slundell/dps_charger/doc/images/0_35v.jpg

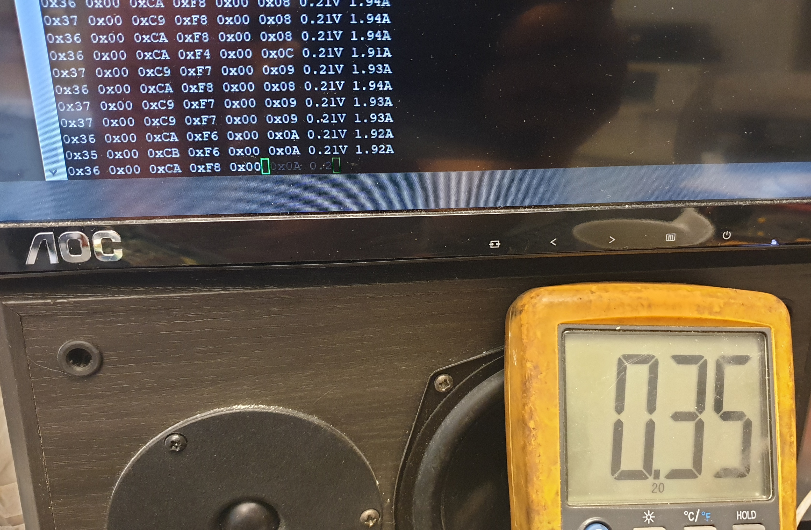
doc/images/0_35v.jpg
