slundell/dps_charger/doc/images/1_94v.jpg

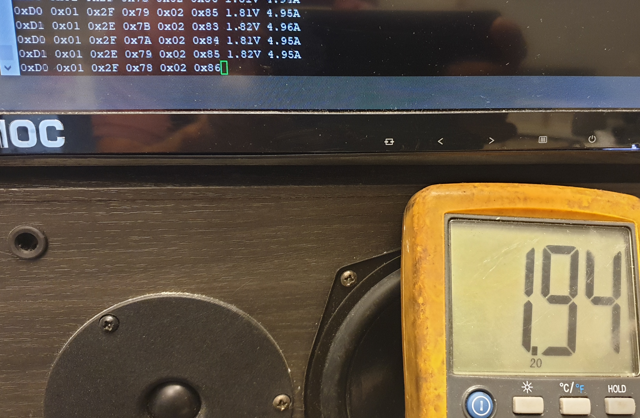
doc/images/1_94v.jpg
