slundell/dps_charger/doc/images/4_45v.jpg

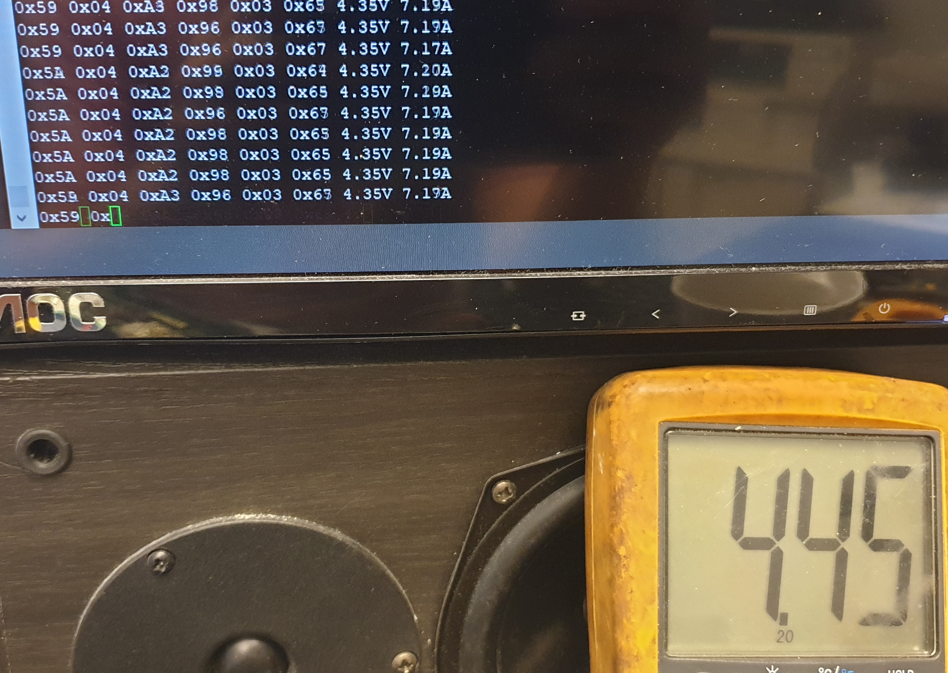
doc/images/4_45v.jpg
