slundell/dps_charger/doc/images/8_73v.jpg

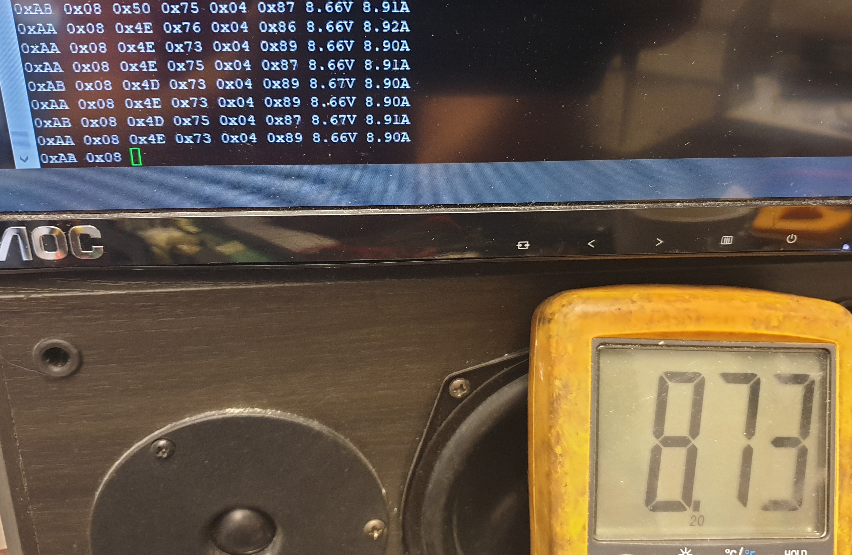
doc/images/8_73v.jpg
