slundell/dps_charger/doc/images/12_42v.jpg

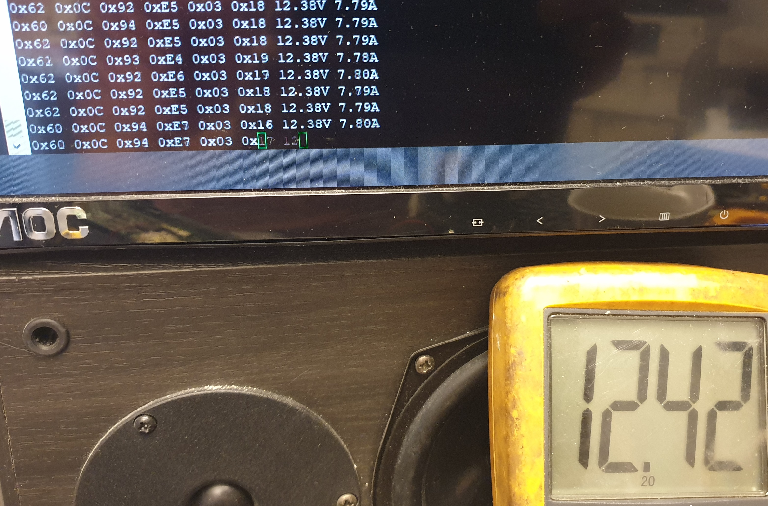
doc/images/12_42v.jpg
