slundell/dps_charger/doc/images/13_68v.jpg

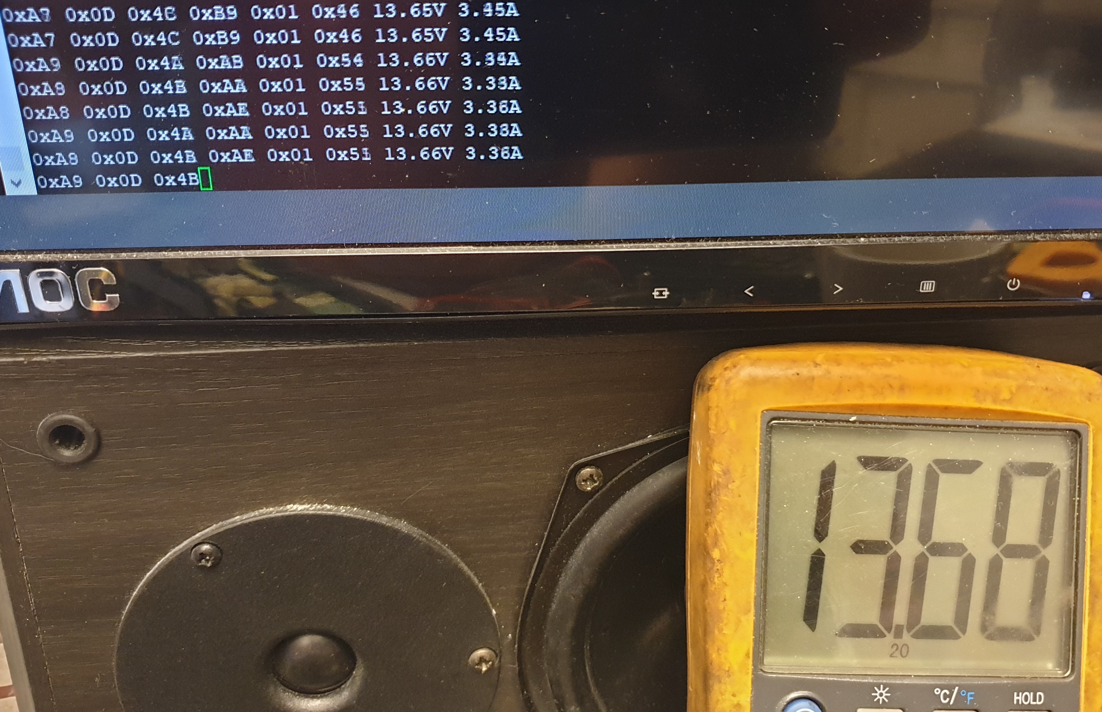
doc/images/13_68v.jpg
