slundell/dps_charger/doc/images/PSU-top.jpg

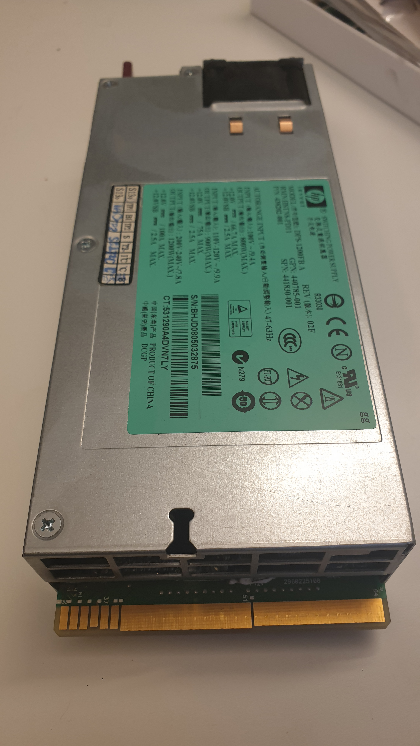
doc/images/PSU-top.jpg
