slundell/dps_charger/doc/random finds/DPS-1200FB turn on resistors.jpg

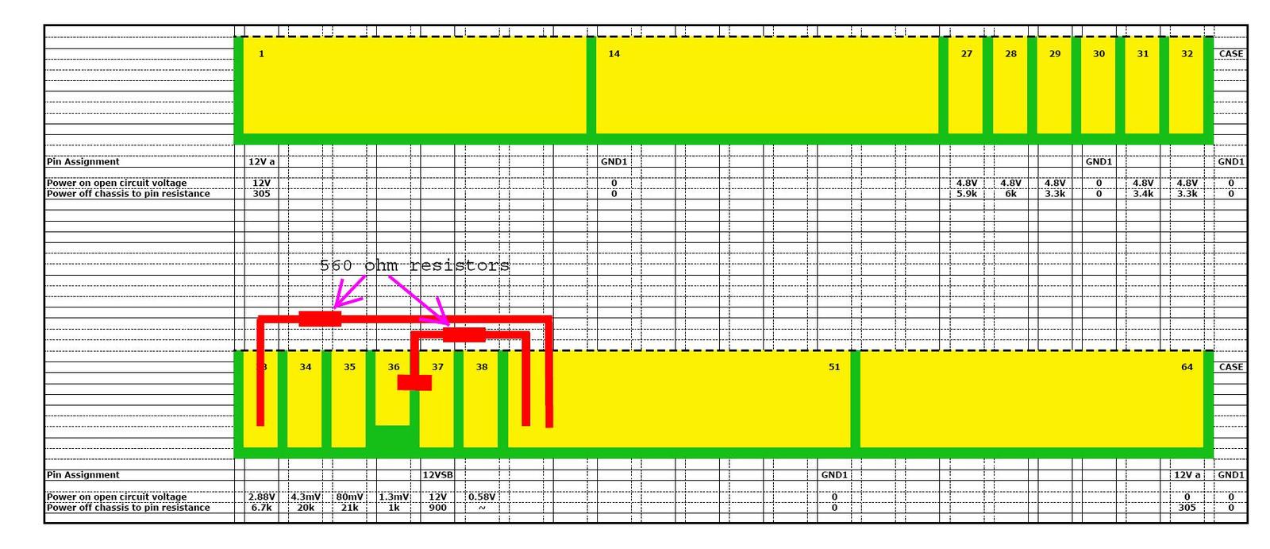
doc/random finds/DPS-1200FB turn on resistors.jpg
