slundell/dps_charger/doc/random finds/pinout.png

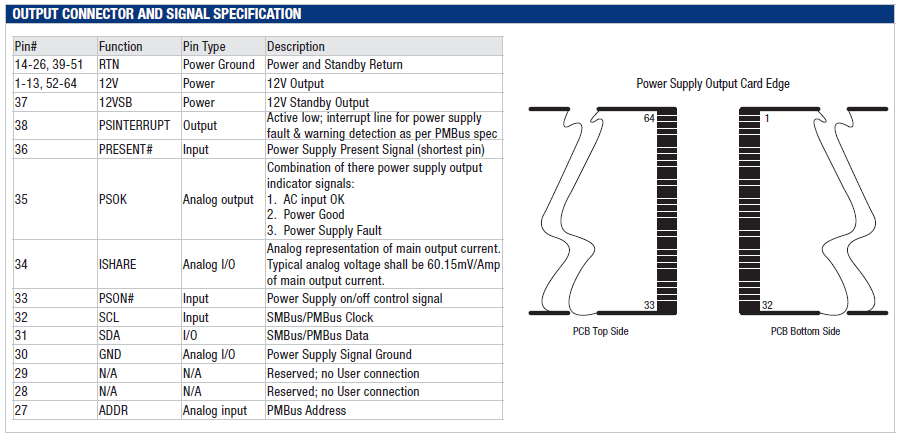
doc/random finds/pinout.png
