slundell/dps_charger/doc/random finds/signals.png

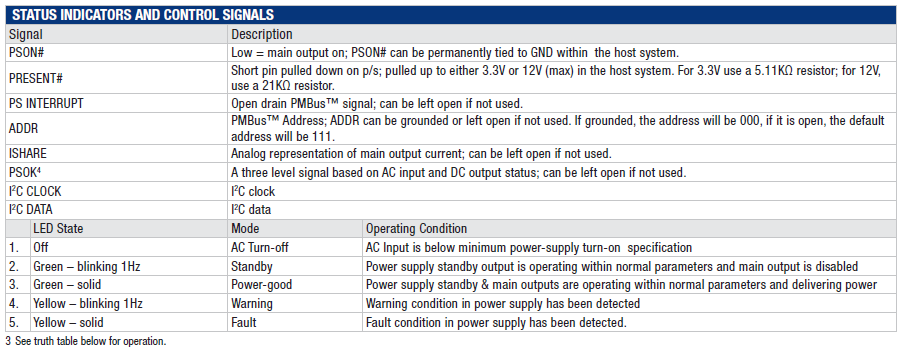
doc/random finds/signals.png
