slundell/dps_charger/(threads)

Thread 1 (2019-09-05):

12VFB Tap

Mateyhv, 2019-09-05:
Hello, I have been following your description and I am interested in lowering the voltage of the PSU to 10,3V so I can set 3xPSUs in series giving 31V. I am not sure how exactly did you set up.. One pin soldered to 12VFB (the whiper), another to 12VSB and the last one to GND but did you disable in some way the voltage control potentiometer on the control board or just leave it there.

Alternatively if I want to use 2xPSU for 30V output I have to increase OVP so the voltage per PSU rises to 15V. If I understood it correctly I have to set a low voltage (~2.70V) to the PIC microcontroller pin #5. How did you do that or better where did you take the voltage from? Did you used another potentiometer? Are there any real issues going up to 15V per PSU?

Thanks

Thread 2 (2020-03-07):

PS Alarm is low everytime?

NilsRo, 2020-03-07:
Hi,

very good project, will adapt the I2C implementation for my charger soon. Actually I am facing that PS Alarm (Pin 38) as low on every PSU and according specification shows a alarm? Is is usual for DPS1200FB?

Regards,
Nils

Thread 3 (2020-10-11):

README pinout error on SCL vs SDA

sparsecli, 2020-10-11:
SDA is 31.
SCL is 32.

The README pin out has reversed the SDA and SCL.

That is confirm by the pinout.png file:
https://github.com/slundell/dps_charger/blob/master/doc/random%20finds/pinout.png

Thread 4 (2020-12-07):

Can you please describe how you were able bypass UVP to reach low voltages like 3.6V

vochong, 2020-12-07:
Hi Simon,

In one of your comments on some other sites, you mentioned that:

"I am hacking/documenting this PSU at https://github.com/slundell/dps_charger . I aim to rebuild it to a fully fledged lab-PSU or charger using an arduino/esp. I have (somehow) managed to work around the UVP. I have some spare cells from an EV project so I tested charging a 16s 20Ah GBS LiFePO4 pack. It happily puts 125A 3.6V through the pack!"

Can you explain how you could bypass OVP to reach low voltages?  I'm very interested in getting the low voltages from this power supply.  Thank you very much.

Thread 5 (2021-01-06):

Voltage adjustment on 12VFB

wegrei, 2021-01-06:
Hi there, thanks for your good explanation. I am planning to build an adjustable battery charger. Try to conttroll output voltage and respectively current by using your method. However I have a problem. Have connected a 12k resistor with a 5k potentiometer in series, the other side of the 20k resistor goes to 12VSB (pin37), the other side of the potentiometer goes to GND (pin 1-14; 39-51) on the board. The wiper goes to 12VFB on the main board as described. With this setup I can adjust the 12VFB from 0v - 2,7V. From 2,7V down to approx. 1,7V the output Voltage stays constant, below that value the unit shuts down. Do you have any idea what is wrong? The model I have is a DPS-1200FB A / HSTNS-PD11 / P/N438202-002
Can you help?
Thanks a lot in advance
Werner
