slundell/dps_charger/src/dps_re.cpp

#include <Arduino.h>
#ifdef ESP8266
#include <ESP8266WiFi.h>
#else
#include <WiFi.h>
#endif
#include <ArduinoOTA.h>


//#define SSI2CMno

//#ifndef SSI2CM
#include "Wire.h"
void my_yield();
void read_all_psu_registers();
void write_psu_mcu_u16(uint8_t, uint16_t);
  
//#else
//#include #include <SlowSoftI2CMaster.h>
//#endif


/*

cf  BANK0:PORTB, RB2 ; turn psu off!
bcf BANK0:PORTC, RC5 ; power off


BANK0:PORTA, RA4 ; adjust I2c address based on address inputs (PA4,PA5,PE3)














0x00: 0D6 ; 'Ö'
0x02: 0B0 ; '°'       ; returns some flags
0x03: 0B1 ; '±'
0x04: 0B2 ; '²'       ; more readable flags
0x05: 0B3 ; '³'
0x06: 0B4 ; '´'       ; status flags incl temperature flags
0x07: 0B5 ; 'µ'
0x08: 0B6 ; '¶'       ; input voltage
0x09: 0B7 ; '·'
0x0A: 0B8 ; '¸'       ; amps in
0x0B: 0B9 ; '¹'
0x0C: 0D7 ; '×'       ; watts in
0x0D: 0D8 ; 'Ø'
0x0E: 0BA ; 'º'       ; output voltage
0x0F: 0BB ; '»'
0x10: 0BC ; '¼'       ; possibly output current
0x11: 0BD ; '½'
0x12: 0D9 ; 'Ù'       ; output watts
0x13: 0DA ; 'Ú'
0x14: 79 ; 'y'
0x15: 79 ; 'y'
0x16: 79 ; 'y'
0x17: 79 ; 'y'
0x18: 79 ; 'y'
0x19: 79 ; 'y'
0x1A: 0BE ; '¾'       ; think this is input air temperature
0x1B: 0BF ; '¿'
0x1C: 0C0 ; 'À'       ; this is some (higher) internal temperature
0x1D: 0C1 ; 'Á'
0x1E: 0C2 ; 'Â'       ; fan speed (rpm?)
0x1F: 0C3 ; 'Ã'
0x20: 79 ; 'y'        ; 
0x21: 79 ; 'y'
0x22: 79 ; 'y'
0x23: 79 ; 'y'
0x24: 79 ; 'y'
0x25: 79 ; 'y'
0x26: 79 ; 'y'
0x27: 79 ; 'y'
0x28: 79 ; 'y'
0x29: 79 ; 'y'
0x2A: 79 ; 'y'
0x2B: 79 ; 'y'
0x2C: 0DB ; 'Û'       ; total watts in (4 bytes)
0x2D: 0DC ; 'Ü'
0x2E: 0DD ; 'Ý'
0x2F: 0DE ; 'Þ'
0x30: 0DF ; 'ß'       ; some simple up-counter (perhaps secs)
0x31: 0E0 ; 'à'
0x32: 0E1 ; 'á'       ; MaxWattsIn
0x33: 0E2 ; 'â'
0x34: 0C4 ; 'Ä'       ; Min recorded input current(?)
0x35: 0C5 ; 'Å'
0x36: 0C6 ; 'Æ'       ; Max recorded output current
0x37: 0C7 ; 'Ç'
0x38: 79 ; 'y'
0x39: 79 ; 'y'
0x3A: 0C8 ; 'È'       ; bitflags ; bits 3,4,5,6 do something
0x3B: 0C9 ; 'É'
0x3C: 0CD ; 'Í'       ; written by cmd 3d
0x3D: 0E4 ; 'ä'
0x3E: 79 ; 'y'
0x3F: 79 ; 'y'
0x40: 0E5 ; 'å'       ; fan related lsb
0x41: 0D4 ; 'Ô'       ; fan related msb
0x42: 79 ; 'y'
0x43: 79 ; 'y'
0x44: 0E6 ; 'æ'
0x45: 0E7 ; 'ç'
0x46: 0E8 ; 'è'
0x47: 0E9 ; 'é'
0x48: 0EA ; 'ê'       ; some value
0x49: 0EB ; 'ë'
0x4A: 0EC ; 'ì'       ; related to above - peak value?
0x4B: 0ED ; 'í'
0x4C: 79 ; 'y'
0x4D: 79 ; 'y'
0x4E: 79 ; 'y'
0x4F: 79 ; 'y'
0x50: 0EE ; 'î'       ; 
0x51: 0EF ; 'ï'
0x52: 0A5 ; '¥'
0x53: 0A6 ; '¦'
0x54: 0A7 ; '§'
0x55: 0A8 ; '¨'
0x56: 0A9 ; '©'
0x57: 0AA ; 'ª'
0x58: 79 ; 'y'
0x59: 79 ; 'y'






*/



   // ! = Known   ? = Guessed
   // T = Tested, A = From asm, D = From doc

bool ignore_registers[0xFF+1];
uint8_t inspect_register;

uint8_t test_cmd  = 0x03;
uint16_t test_data = 0x0000;

void setup_ignore_registers(){


/*

Back-powering the PSU: 

0x02: 0x03 0x06 00000011 00000110 774                   was: 0x03 0x07 00000011 00000111 775
0x04: 0x00 0x09 00000000 00001001 9                     was: 0x00 0x00 00000000 00000000 0
0x06: 0x00 0x20 00000000 00100000 32                    was: 0x00 0x00 00000000 00000000 0

*/



/*  
cmd 0x57=(?0x28) read EEPROM 
max cmd = 0x59 (=?0x29)



*/

/*

ENABLE# LOW

|HP PROLIANT SERVER PS                                 |
| Input: 230.53V  0.13A    | Output: 11.96V  7.59A     |
| Fan: 3360.00/s | Intake: 0.00C  | Internal  86.00C  |
________________________________________________________


0x02: 0x03 0x07 00000011 00000111 775                   was: 0x03 0x02 00000011 00000010 770


*/















  ignore_registers[0x00] = false; 
  ignore_registers[0x02] = false; // [?D] Flags. Power Good?
  ignore_registers[0x04] = false; // [?T] Flags? 0x00 0x00 -> 0x00 0x16 when pulling power
  ignore_registers[0x06] = false; // [?T] Under voltage alarm flag? b.3 = pot3 overflow?
  ignore_registers[0x08] = true;  // [!T] grid voltage
  ignore_registers[0x0A] = true;  // [!T] grid amperage
  ignore_registers[0x0C] = true;  // [!T] grid wattage
  ignore_registers[0x0E] = true;  // [!T] out voltage

  ignore_registers[0x10] = true;  // [!T] out amperage
  ignore_registers[0x12] = true;  // [!T] out wattage
  ignore_registers[0x14] = false;
  ignore_registers[0x16] = false;
  ignore_registers[0x18] = false;
  ignore_registers[0x1A] = true;  // [!T] intake temp
  ignore_registers[0x1C] = true;  // [!T] internal temp
  ignore_registers[0x1E] = true;  // [!T] fan speed actual


  ignore_registers[0x20] = false;
  ignore_registers[0x22] = false;
  ignore_registers[0x24] = false;
  ignore_registers[0x26] = false;
  ignore_registers[0x28] = false;
  ignore_registers[0x2A] = false;  
  ignore_registers[0x2C] = true;  // [!T] Ws in 32bits
  ignore_registers[0x2E] = false;  // [?T] Very slow counter. Resets when unplugging

  
  ignore_registers[0x30] = true;  // [!T] Uptime s
  ignore_registers[0x32] = true;  // [?D] Peak watts in 
  ignore_registers[0x34] = true;  // [?D] Min amps in
  ignore_registers[0x36] = true;  // [?D] Peak amps out
  ignore_registers[0x38] = false; 
  ignore_registers[0x3A] = false; // [?D] Cool flags1 
    // 0x3A:5 seems to be "Power out is on" flag

/*
0x3A: 00000000 00000001
Register 0x3A changed from 0 to 1 after reg 0x3A bit 0
0x3A: 00000000 00000010
Register 0x3A changed from 1 to 2 after reg 0x3A bit 1
0x3A: 00000000 00000100
Register 0x3A changed from 2 to 4 after reg 0x3A bit 2
0x3A: 00000000 00001000
Register 0x3A changed from 4 to 8 after reg 0x3A bit 3
0x3A: 00000000 00010000
Register 0x3A changed from 8 to 16 after reg 0x3A bit 4
0x3A: 00000000 00100000
Register 0x3A changed from 16 to 0 after reg 0x3A bit 5
0x3A: 00000000 01000000
0x3A: 00000000 10000000
0x3A: 00000001 00000000
0x3A: 00000010 00000000
0x3A: 00000100 00000000
0x3A: 00001000 00000000
0x3A: 00010000 00000000
0x3A: 00100000 00000000
0x3A: 01000000 00000000
0x3A: 10000000 00000000

  // 0x3A: 0x00 0x1F 00000000 00011111 31 batt power + grid power                   
  //  was: 0x00 0x3F 00000000 00111111 63 batt power no grid power

  // Last 6b is settable 0x3A: 0x00 0x3F 00000000 00111111 63
*/

  ignore_registers[0x3C] = false; // [?D] Cool flags2
  /* All bits are settable 0x3C: 0xFF 0xFF 11111111 11111111 65535 -> Fan speeds up

0x3C: 00000000 00000001
Register 0x02 changed from 775 to 839 after reg 0x3C bit 0
Register 0x3A changed from 0 to 64 after reg 0x3C bit 0
Register 0x3C changed from 0 to 1 after reg 0x3C bit 0
0x3C: 00000000 00000010
Register 0x3C changed from 1 to 2 after reg 0x3C bit 1
0x3C: 00000000 00000100
Register 0x3C changed from 2 to 4 after reg 0x3C bit 2
0x3C: 00000000 00001000
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
  ignore_registers[0x92] = false; // [?] 
  ignore_registers[0x94] = false; // [?] 
  ignore_registers[0x96] = false; // [?] 
  ignore_registers[0x98] = false; // [?] 
  ignore_registers[0x9A] = false; // [?] 
  ignore_registers[0x9C] = false; // [?] 
  ignore_registers[0x9E] = false; // [?] 

  ignore_registers[0xA0] = false; // [?] 
  ignore_registers[0xA2] = false; // [?] 
  ignore_registers[0xA4] = false; // [?] 
  ignore_registers[0xA6] = false; // [?] 
  ignore_registers[0xA8] = false; // [?] 
  ignore_registers[0xAA] = false; // [?] 
  ignore_registers[0xAC] = false; // [?] 
  ignore_registers[0xAE] = false; // [?] 

  ignore_registers[0xB0] = false; // [?] 
  ignore_registers[0xB2] = false; // [?] 
  ignore_registers[0xB4] = false; // [?] 
  ignore_registers[0xB6] = false; // [?] 
  ignore_registers[0xB8] = false; // [?] 
  ignore_registers[0xBA] = false; // [?] 
  ignore_registers[0xBC] = false; // [?] 
  ignore_registers[0xBE] = false; // [?] 

  ignore_registers[0xC0] = false; // [?] 
  ignore_registers[0xC2] = false; // [?] 
  ignore_registers[0xC4] = false; // [?] 
  ignore_registers[0xC6] = false; // [?] 
  ignore_registers[0xC8] = false; // [?] 
  ignore_registers[0xCA] = false; // [?] 
  ignore_registers[0xCC] = false; // [?] 
  ignore_registers[0xCE] = false; // [?] 

  ignore_registers[0xD0] = false; // [?] 
  ignore_registers[0xD2] = false; // [?] 
  ignore_registers[0xD4] = false; // [?] 
  ignore_registers[0xD6] = false; // [?] 
  ignore_registers[0xD8] = false; // [?] 
  ignore_registers[0xDA] = false; // [?] 
  ignore_registers[0xDC] = false; // [?] 
  ignore_registers[0xDE] = false; // [?] 

  ignore_registers[0xE0] = false; // [?] 
  ignore_registers[0xE2] = false; // [?] 
  ignore_registers[0xE4] = false; // [?] 
  ignore_registers[0xE6] = false; // [?] 
  ignore_registers[0xE8] = false; // [?] 
  ignore_registers[0xEA] = false; // [?] 
  ignore_registers[0xEC] = false; // [?] 
  ignore_registers[0xEE] = false; // [?] 

  ignore_registers[0xF0] = false; // [?] 
  ignore_registers[0xF2] = false; // [?] 
  ignore_registers[0xF4] = false; // [?] 
  ignore_registers[0xF6] = false; // [?] 
  ignore_registers[0xF8] = false; // [?] 
  ignore_registers[0xFA] = false; // [?] 
  ignore_registers[0xFC] = false; // [?] 
  ignore_registers[0xFE] = false; // [?] 


  
/*

|HP PROLIANT SERVER PS                                 |
| Input: 228.13V  0.16A    | Output: 12.73V  7.83A     |
| Fan: 3360.00/s | Intake: 30.00C  | Internal  42.22C  |
________________________________________________________


0x1A: 0x00 0x18 00000000 00011000 24                    was: 0x00 0x18 00000000 00011000 24
0x84: 0x1B 0xD9 00011011 11011001 7129                  was: 0x1B 0xCD 00011011 11001101 7117
0x86: 0x00 0xC7 00000000 11000111 199                   was: 0x00 0xC8 00000000 11001000 200
0x87: 0x0C 0xBB 00001100 10111011 3259                  was: 0x0C 0xBC 00001100 10111100 3260
0x88: 0x03 0xE6 00000011 11100110 998                   was: 0x03 0xE9 00000011 11101001 1001
0x89: 0x00 0xC6 00000000 11000110 198                   was: 0x00 0xC7 00000000 11000111 199
0x8E: 0x0D 0x80 00001101 10000000 3456                  was: 0x0D 0xC0 00001101 11000000 3520
0x8F: 0x0D 0x20 00001101 00100000 3360                  was: 0x0D 0x98 00001101 10011000 3480
0x96: 0xF3 0xAA 11110011 10101010 62378                 was: 0xEE 0xFB 11101110 11111011 61179
0x98: 0x2E 0x72 00101110 01110010 11890                 was: 0x2E 0x6C 00101110 01101100 11884
0x9A: 0x00 0x18 00000000 00011000 24                    was: 0x00 0x18 00000000 00011000 24









Pulling AC power :
  0x01: 0x00 0x04 00000000 00000100 4                     was: 0x03 0x07 00000011 00000111 775


  
0x02: 0x00 0x00 00000000 00000000 0                     was: 0x00 0x10 00000000 00010000 16
0x1A: 0x00 0x18 00000000 00011000 24                    was: 0x00 0x12 00000000 00010010 18



Reconnecting AC power: 
  0x01: 0x01 0x06 00000001 00000110 262                   was: 0x00 0x04 00000000 00000100 4
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
0xD8: 0x00 0x00 0x00 0x00 0x00 0x00 0x00 0x00 ........
0xE0: 0x00 0x00 0x00 0x00 0x00 0x00 0x00 0x00 ........
0xE8: 0x00 0x00 0x00 0x00 0x00 0x00 0x00 0x00 ........
0xF0: 0x00 0x00 0x00 0x00 0x00 0x00 0x00 0x00 ........
0xF8: 0x00 0x00 0x00 0x00 0x00 0x00 0x00 0x00 ........
*/



uint8_t factory_eeprom[] = {
  0xFE,0x00,0x00,0x01,0x05,0x0E,0x00,0xEB,
  0x01,0x04,0x19,0x08,0x06,0x6C,0xC0,0xC0,
  0xC0,0xCA,0x34,0x34,0x31,0x38,0x33,0x30,
  0x2D,0x30,0x30,0x31,0xC8,0x31,0x30,0x2F,
  0x31,0x30,0x2F,0x30,0x38,0xC1,0x00,0x5B,
  0x01,0x09,0x19,0xC5,0x44,0x45,0x4C,0x54,
  0x41,0xDA,0x48,0x50,0x20,0x50,0x52,0x4F,
  0x4C,0x49,0x41,0x4E,0x54,0x20,0x53,0x45,
  0x52,0x56,0x45,0x52,0x20,0x50,0x53,0x20,
  0x20,0x20,0x20,0x20,0xCA,0x34,0x33,0x37,
  0x35,0x37,0x32,0x2D,0x42,0x32,0x31,0xC2,
  0x30,0x31,0xCE,0x35,0x41,0x4D,0x4A,0x51,
  0x30,0x44,0x34,0x44,0x58,0x4F,0x33,0x4C,
  0x55,0x00,0x00,0xC1,0x00,0x00,0x00,0x0A,
  0x00,0x02,0x18,0x12,0xD4,0xB0,0x04,0xA0,
  0x05,0x1E,0x05,0x28,0x23,0x90,0x33,0x50,
  0x46,0x20,0x67,0x2F,0x3F,0x0A,0x1A,0xA0,
  0x15,0x00,0x00,0x00,0x00,0x01,0x02,0x0D,
  0xB2,0x3E,0x01,0xCE,0x04,0x74,0x04,0xEC,
  0x04,0x78,0x00,0x64,0x00,0x10,0x27,0x01,
  0x02,0x0D,0xEF,0x01,0x82,0xB0,0x04,0x38,
  0x04,0x28,0x05,0x78,0x00,0x00,0x00,0xFA,
  0x00,0xD0,0x82,0x12,0xE3,0xB9,0x0B,0x00,
  0x00,0x03,0x20,0x03,0xC0,0x13,0x01,0x80,
  0x00,0x00,0x00,0x00,0x00,0x00,0x50,0x48,
  0x00,0x00,0x00,0x00,0x00,0x00,0x00,0x00,
  0x00,0x00,0x00,0x00,0x00,0x00,0x00,0x00,
  0x00,0x00,0x00,0x00,0x00,0x00,0x00,0x00,
  0x00,0x00,0x00,0x00,0x00,0x00,0x00,0x00,
  0x00,0x00,0x00,0x00,0x00,0x00,0x00,0x00,
  0x00,0x00,0x00,0x00,0x00,0x00,0x00,0x00,
  0x00,0x00,0x00,0x00,0x00,0x00,0x00,0x00
};

#include "./stassid.h"

#ifndef STASSID
#define STASSID "your-ssid"
#define STAPSK  "your-password"
#endif

const char* ssid = STASSID;
const char* password = STAPSK;

char psu_spn[11];
char psu_date[9];
char psu_name[27];
//char psu_mfu[5];
char psu_ct[15];

WiFiServer TelnetServer(23);
WiFiClient Telnet;

uint8_t psu_mcu_addr = 0xFF;
uint8_t psu_mem_addr = 0xFF;


 double psu_grid_voltage = 0;
 double psu_grid_amperage = 0;
 double psu_grid_wattage = 0;
 double psu_out_voltage = 0;
 double psu_out_amperage = 0;
 double psu_out_wattage = 0;
 double psu_intake_temp = 0;
 double psu_internal_temp = 0;
 double psu_fan_speed_actual = 0;
 double psu_fan_speed_desired = 0;
 /*double psu_cool_flags_1 = 0;
 double psu_cool_flags_2 = 0;
 double psu_voltage_threshold_1 = 0;
 double psu_voltage_threshold_2 = 0;*/



/****************************************************** U T I L I T Y */

void print_byte(uint8_t b){
  Telnet.print("0x");
  if (b < 16)
    Telnet.print("0");
  Telnet.print(b, HEX);
}

    
void print_bits(uint8_t b){    
  for(uint8_t mask = 0x80; mask; mask >>= 1){
   if (mask & b)
       Telnet.print('1');
   else
       Telnet.print('0');
  }
}

void print_data(){
    Telnet.println("________________________________________________________");
    Telnet.print("|");
    Telnet.print(psu_name);
    Telnet.println("                            |");
    Telnet.print("| Input: ");
    Telnet.print(psu_grid_voltage);
    Telnet.print("V  ");
    Telnet.print(psu_grid_amperage);
    
    Telnet.print("A    | Output: ");
    Telnet.print(psu_out_voltage);
    Telnet.print("V  ");
    Telnet.print(psu_out_amperage);
    Telnet.println("A     |");

    Telnet.print("| Fan: ");
    Telnet.print(psu_fan_speed_actual);
    Telnet.print("/s | Intake: ");
    Telnet.print(psu_intake_temp);
    Telnet.print("C  | Internal  ");
    Telnet.print(psu_internal_temp);
    Telnet.println("C  |");



    Telnet.println("________________________________________________________\n\n");
}

/****************************************************** i 2 C - f u n c t i o n s */


void scan_for_device(uint8_t from, uint8_t to, uint8_t& ret) {
  byte address;
  
  
  for (address = from ; address <= to; address++ )  {
/*    
#ifdef SSI2CM
    bool ack = i2c_start(i<<1 | I2C_WRITE); 
#else
*/
    Wire.beginTransmission(address);
    uint8_t ack = Wire.endTransmission();
//#endif
    if (ack == 0){
      Telnet.print("Device found at ");
      print_byte(address);
      Telnet.println();
      ret = address;
      return;
    } 
  }

  if (ret == 0xFF) {
    Telnet.print("No device found between ");
    print_byte(from);
    Telnet.print(" and ");
    print_byte(to);
    Telnet.println(".");
  }
  
}


/****************************************************** H O U S E K E E P I N G */

void handleTelnet() {
    if (TelnetServer.hasClient()) {
      if (!Telnet || !Telnet.connected()) {
        if (Telnet) Telnet.stop();
        Telnet = TelnetServer.available();
      } else {
        TelnetServer.available().stop();
      }
    }
}

void reconnect_wifi() {  
    WiFi.mode(WIFI_STA);  
    WiFi.begin(ssid, password);  
    while (WiFi.status() != WL_CONNECTED) {  
      Serial.println("Connecting to wifi...");
        delay(500);  
    }  
}  


/****************************************************** P S U  E E P R O M */


/*#ifdef SSI2CM
uint8_t read_eeprom_byte(uint8_t addr){
  i2c_start(deviceAddress<<1 | I2C_WRITE);
  i2c_write(addr);
  i2c_rep_start(deviceAddress<<1 | I2C_READ);
  uint8_t b = i2c_read(true);
  i2c_stop();
  return b;
}


void read_eeprom_string(uint8_t addr, uint8_t len, char* s)
{
  for (uint8_t i= addr; i<addr+len; i++){
    s[i] = read_eeprom_byte(i);
    i++;
  }
  s[i] = '\0';
}

#else*/

uint8_t read_eeprom_byte(long addr)
{
  Wire.beginTransmission(psu_mem_addr);

  Wire.write((uint8_t)(addr));
  Wire.endTransmission();

  Wire.requestFrom((uint8_t)psu_mem_addr, (uint8_t)1);

  uint8_t rdata = 0xFF;
  if (Wire.available()) rdata = Wire.read();
  return rdata;
}

void write_eeprom_byte(uint8_t addr, uint8_t b){
  Wire.beginTransmission(psu_mem_addr);
  Wire.write((uint8_t)(addr));
  Wire.write((uint8_t)(b));
  Wire.endTransmission();
}

void read_eeprom_string(uint8_t addr, uint8_t len, char* s)
{
  Wire.beginTransmission(psu_mem_addr);

  Wire.write((uint8_t)(addr));
  Wire.endTransmission();

  Wire.requestFrom((uint8_t)psu_mem_addr, (uint8_t)len);


  uint8_t i=0;
  while (Wire.available() && (i <= len)){
    s[i] = Wire.read();
    i++;
  }
  s[i] = '\0';
}
//#endif
void read_eeprom(){

  read_eeprom_string(0x12, 10, psu_spn);
  read_eeprom_string(0x1D, 8, psu_date);
  read_eeprom_string(0x32, 26, psu_name);
  read_eeprom_string(0x5B, 14, psu_ct);
  
  Telnet.print("Found: ");
  Telnet.println(psu_name);

}

void read_entire_eeprom(){
  for (uint16_t a = 0 ; a<0xFF; a+=8){
    print_byte(a);
    Telnet.print(": ");
    for (uint8_t b = 0 ; b<8; b++){
      uint8_t bte = read_eeprom_byte((uint8_t)(a+b));
      print_byte(bte);
      Telnet.print(" ");
    }
    for (uint8_t b = 0 ; b<8; b++){
      uint8_t bte = read_eeprom_byte((uint8_t)(a+b));
      if ((bte >= 0x20) && (bte <= 0x7E)){ //printable chars
        Telnet.print((char)bte);
      } else {
        Telnet.print('.');
      }
    }
    Telnet.println();
    my_yield();
  }

}

void factory_reset_eeprom(){
  Telnet.println("Factory reset of eeprom");
  delay(3000);
  for (uint16_t a = 0 ; a<0xFF; a++){
    write_eeprom_byte(a, factory_eeprom[a]);
  }
  Telnet.println("done");
  read_entire_eeprom();
}

/*

uint16_t eeprom[255];
uint16_t eeprom_old[255];
uint16_t eeprom_last_change[255];
uint8_t eeprom_last_change_age[255];



void read_all_eeprom_changes(){

  for (uint8_t i=0; i<255;++i){
   // if (ignore_eeprom[i]) continue;
    eeprom[i] = read_eeprom_byte(i);
    if (eeprom[i] != eeprom_old[i]) {
      eeprom_last_change_age[i] = 0;
      eeprom_last_change[i] = eeprom_old[i];
    }
    else {
      if (eeprom_last_change_age[i]!=0xFF){
        eeprom_last_change_age[i]++;
      }
    }
    eeprom_old[i] = eeprom[i];
  }
}

*/


/****************************************************** P S U  M C U */


bool checksum(uint8_t* msg, uint8_t msg_len){

  uint8_t cs = 0;
  for (uint8_t i=0; i<msg_len; ++i){
    //print_byte(msg[i]); 
    //Telnet.print(" ");
    cs += msg[i];
  }
  cs = (( 0xFF - cs) + 1) & 0xFF;
  //Telnet.print("  cs: ");
  //print_byte(cs);
  //Telnet.println();
  if (cs) { 
    Telnet.print("Wrong checksum: ");
    Telnet.println(cs);
  }
  // cs == 0 > A-OK
  // (cs == 0) == true > A-OK
  //
  return (cs==0);

}
/*
#ifdef SSI2CM

#else
*/
bool read_psu_mcu(uint8_t reg, uint8_t len, uint8_t* msg, bool verbose = true){
    digitalWrite(LED_BUILTIN, HIGH);
    //reg = reg << 1;
    uint8_t cs = reg + (psu_mcu_addr<<1);
    uint8_t reg_cs = ((0xff-cs)+1) & 0xff;
    Wire.beginTransmission(psu_mcu_addr);
    if (verbose) {
      Telnet.print("[>");
      print_byte(psu_mcu_addr);
      Telnet.print("] ");
    }
    Wire.write((uint8_t)(reg));
    if (verbose) {
      print_byte(reg);
      Telnet.print(": ");
    }
    Wire.write((uint8_t)(reg_cs));
    if (verbose) {
      print_byte(reg_cs);
      Telnet.print(" ");
    }
    Wire.endTransmission();
    if (verbose) {
      Telnet.println("[S]");
    }
    delay(1);

    Wire.requestFrom((uint8_t)psu_mcu_addr, (uint8_t)len, (uint8_t)false);
    if (verbose) {
      Telnet.print("[<");
      print_byte(psu_mcu_addr);
      Telnet.print("] ");
      print_byte(reg);
      Telnet.print(": ");
    }
    uint8_t i = 0;
    //uint8_t msg[len];
    while (Wire.available() && (i < len)){ 
      msg[i] = Wire.read(); 
      if (verbose) {
        print_byte((uint8_t)msg[i]);
        Telnet.print(" ");
      }
      i++;
    }
    if (verbose) {
      Telnet.println("");
    }
    if (i!=len){
      Telnet.print("Expected to read ");
      Telnet.print(len);
      Telnet.print(" bytes, but got ");
      Telnet.print(i);
      Telnet.println(" bytes.");
    }
    digitalWrite(LED_BUILTIN, LOW);
    return checksum(msg, len);

}
/*
#endif
*/
bool read_psu_mcu_u8(uint8_t reg, uint8_t& ret, bool verbose=true){
  uint8_t msg[2];
  if (!read_psu_mcu(reg, 2, msg, verbose)){
    return false;
  }
  ret = msg[0];
  return true;
}

bool read_psu_mcu_u16(uint8_t reg, uint16_t& ret, bool verbose=true){
  uint8_t msg[3];
  if (!read_psu_mcu(reg, 3, msg, verbose)){
    return false;
  }
  ret = (msg[1] << 8) + msg[0];
  return true;
}


bool read_psu_mcu_f16(uint8_t reg, double scale, double& ret, bool verbose=true){
  uint16_t u16;
  if (!read_psu_mcu_u16(reg, u16, verbose)){
    return false;
  }
  ret = scale * u16;
  return true;
}

bool read_psu_mcu_flags16(uint8_t reg, uint16_t& ret, bool verbose=true){
  if (!read_psu_mcu_u16(reg, ret, verbose)){
    return false;
  }
  return true;
}



bool read_psu_grid_voltage(double& ret, bool verbose = true){
  return (read_psu_mcu_f16(0x08, 0.032, ret, verbose));
}

bool read_psu_grid_amperage(double& ret, bool verbose = true){
  return (read_psu_mcu_f16(0x0A, 1/128., ret, verbose));
}

bool read_psu_grid_wattage(double& ret, bool verbose = true){
  return (read_psu_mcu_f16(0x0C, 2., ret, verbose));
}

bool read_psu_out_voltage(double& ret, bool verbose = true){
  return (read_psu_mcu_f16(0x0E, 1./256, ret, verbose));
}

bool read_psu_out_amperage(double& ret, bool verbose = true){
  return (read_psu_mcu_f16(0x10, 1./128, ret, verbose));
}

bool read_psu_out_wattage(double& ret, bool verbose = true){
  return (read_psu_mcu_f16(0x1A, 2., ret, verbose));
}

bool read_psu_intake_temp(double& ret, bool verbose = true){
  bool r = (read_psu_mcu_f16(0x18, 1./32., ret, verbose));
  //ret = (ret - 32.) * 5./9.;
  return r;
}

bool read_psu_internal_temp(double& ret, bool verbose = true){
  bool r = (read_psu_mcu_f16(0x1C, 1./32., ret, verbose));
  //ret = (ret - 32.) * 5./9.;
  return r;
}

bool read_psu_fan_speed_actual(double& ret, bool verbose = true){
  return (read_psu_mcu_f16(0x1E, 1., ret, verbose));
}

bool read_psu_fan_speed_desired(double& ret, bool verbose = true){
  return (read_psu_mcu_f16(0x40, 1., ret, verbose));
}

bool read_psu_cool_flags_1(uint16_t& ret, bool verbose = true){
  return (read_psu_mcu_u16(0x3A, ret, verbose));
}

bool read_psu_cool_flags_2(uint16_t& ret, bool verbose = true){
  return (read_psu_mcu_u16(0x3A, ret, verbose));
}


bool read_psu_out_max_amperage(double& ret, bool verbose = true){
  return (read_psu_mcu_f16(0x36, 1./128, ret, verbose));
}


bool read_psu_is_enabled(bool& ret, bool verbose = true){
  uint16_t u16;
  bool r = read_psu_mcu_flags16(0x02, u16, verbose);
  ret = ((u16 & 0x05)  == 0x05);
  return r;
}

bool read_psu_data(bool verbose = true){
  return ((read_psu_grid_voltage(psu_grid_voltage, verbose)) &&
  (read_psu_grid_amperage(psu_grid_amperage, verbose)) &&
  (read_psu_grid_wattage(psu_grid_wattage, verbose)) &&
  (read_psu_out_voltage(psu_out_voltage, verbose)) &&
  (read_psu_out_amperage(psu_out_amperage, verbose)) &&
  (read_psu_out_wattage(psu_out_wattage, verbose)) &&
  (read_psu_intake_temp(psu_intake_temp, verbose)) &&
  (read_psu_internal_temp(psu_internal_temp, verbose)) &&
  (read_psu_fan_speed_actual(psu_fan_speed_actual, verbose)) &&
  (read_psu_fan_speed_desired(psu_fan_speed_desired, verbose)));
}

uint16_t registers[255];
uint16_t registers_old[255];
uint16_t registers_last_change[255];
uint8_t registers_last_change_age[255];


void read_psu_mcu_registers_init(){
  uint16_t u16 = 0;
  for (uint8_t i=0; i<255;++i){
    read_psu_mcu_u16(i, u16);
    registers[i] = u16;
    registers_old[i] = u16;
    registers_last_change[i] = u16;
    registers_last_change_age[i]=0xFF;
    ignore_registers[i] = false;
  }
}

void read_psu_mcu_changing_registers(){

  uint16_t u16 = 0;
  for (uint8_t i=0; i<255;++i){
    read_psu_mcu_u16(i, u16, false);
    registers_old[i] = registers[i];
    registers[i] = u16;
  }

  Telnet.println("\033c");
  read_psu_data(false);

  for (uint8_t i=0; i<255;++i){
    //if (ignore_registers[i]) continue;

    if (registers[i] != registers_old[i]) {
      registers_last_change_age[i] = 0;
      registers_last_change[i] = registers_old[i];
    }
    else {
      if (registers_last_change_age[i]!=0xFF){
        registers_last_change_age[i]++;
      }
    }
    if (/*(i==test_cmd) || */(registers_last_change_age[i] < 25)){
      print_byte(i);
      Telnet.print(": ");
      
      print_byte((uint8_t)(registers[i]>>8));
      Telnet.print(" ");
      print_byte(registers[i] & 0xFF);
      Telnet.print(" ");
      
      print_bits((uint8_t)(registers[i]>>8));
      Telnet.print(" ");
      print_bits(registers[i] & 0xFF);

      Telnet.print(" ");
      Telnet.print(registers[i]);
      
      Telnet.print("             \twas: ");

      print_byte((uint8_t)(registers_last_change[i]>>8));
      Telnet.print(" ");
      print_byte(registers_last_change[i] & 0xFF);
      Telnet.print(" ");
      
      print_bits((uint8_t)(registers_last_change[i]>>8));
      Telnet.print(" ");
      print_bits(registers_last_change[i] & 0xFF);

      Telnet.print(" ");
      Telnet.print(registers_last_change[i]);
      
      Telnet.print('\n');
    }
  }
  Telnet.println();
  /*
  if (test_cmd != 0) {
    Telnet.print("\nTesting command: ");
    print_byte((uint8_t)(test_cmd));
    Telnet.print(": ");
    print_byte((uint8_t)(test_data >> 8));
    Telnet.print(" ");
    print_byte((uint8_t)(test_data & 0xFF));
  }
*/

}

void dump_all_mcu_registers(){

  uint16_t u16 = 0;
  for (uint8_t i=0; i<255;++i){
    read_psu_mcu_u16(i, u16, true);
    registers[i] = u16;
  }
  for (uint8_t i=0; i<255;++i){
 
    print_byte(i);
    Telnet.print(": ");
    
    print_byte((uint8_t)(registers[i]>>8));
    Telnet.print(" ");
    print_byte(registers[i] & 0xFF);
    Telnet.print(" ");
    
    print_bits((uint8_t)(registers[i]>>8));
    Telnet.print(" ");
    print_bits(registers[i] & 0xFF);

    Telnet.print(" ");
    Telnet.print(registers[i]);
    
    Telnet.println();
    my_yield();
  }

  Telnet.println();
}

void fuzz_for_voltage(){

  uint16_t tw_idx;
  double volt;
  double old_volt;

  uint16_t test_words[] = { //0x0000, // [1]
                            //0x0001, 0x0002, 0x0004, 0x0008, 0x0010, 0x0020, 0x0040, 0x0080, 0x0100, 0x0200, 0x0400, 0x0800, 0x1000, 0x2000, 0x4000, 0x8000, // [16] walking 1s
                            //0x0001, 0x0003, 0x0007, 0x000F, 0x001F, 0x003F, 0x007F, 0x00FF, 0x01FF, 0x03FF, 0x07FF, 0x0FFF, 0x1FFF, 0x3FFF, 0x7FFF, 0xFFFF, // [16] fill with 1s from left
                            //0x5555, 0xAAAA, // [2] Alterneting 1s and 0s
                            //0x0F00//, // [1] 15V
                            //0x0D00//, // [1] 13V
                            //0x0B00  // [1] 11V 
                            0x0A00//, // [1] 10V
                          };

  uint16_t num_test_words =  1;

  uint8_t test_regs[] = {0x44, 0x48, 0x50, 0x52, 0x54};
  uint8_t num_test_regs = 5;
  

  read_psu_out_voltage(volt);

  old_volt=volt;
  for (uint8_t reg_idx = 0; reg_idx < num_test_regs; reg_idx++){


    read_all_psu_registers();
    print_byte(test_regs[reg_idx]);
    Telnet.println();
    my_yield();

    Telnet.print(volt);
    Telnet.println("V");
    for (tw_idx = 0; tw_idx < num_test_words; tw_idx++){
      
      
      write_psu_mcu_u16(test_regs[reg_idx], test_words[tw_idx]);

      Telnet.print(tw_idx);
      Telnet.print(" ");
      print_byte(test_words[tw_idx] >> 8);
      Telnet.print(" ");
      print_byte(test_words[tw_idx] & 0xFF);
      Telnet.print(" : ");


      print_bits(test_words[tw_idx] >> 8);
      Telnet.print(" ");
      print_bits(test_words[tw_idx] & 0xFF);
      Telnet.println();

      //read_psu_mcu_changing_registers();
      read_psu_out_voltage(volt);
      //Telnet.println((old_volt - volt));
      if (((old_volt - volt) > 0.08) || ((old_volt - volt) < -0.08)){
          Telnet.println("Voltage changed from ");
          Telnet.print(old_volt);
          Telnet.print("V to ");
          Telnet.print(volt);
          Telnet.println("V after reg ");
          print_byte(test_regs[reg_idx]);
          Telnet.print(" value ");
          Telnet.println(test_words[tw_idx], HEX);
          for (uint8_t w=0; w<0xF0; w++){
            Telnet.print(".");
            Telnet.flush();
            my_yield();
          }
      }
      old_volt=volt;
      //force_psu_fan(3200);
     // delay(50);
    }
  }  
}

void read_all_psu_registers(){
  uint16_t u16;
  for (uint8_t i=0; i<255;++i){
    if (ignore_registers[i]) continue;
    read_psu_mcu_u16(i, u16);
    if (registers[i] != registers_old[i]) {
      registers_last_change_age[i] = 0;
      registers_last_change[i] = registers_old[i];
    }
    else {
      if (registers_last_change_age[i]!=0xFF){
        registers_last_change_age[i]++;
      }
    }
    registers_old[i] = registers[i];
  }
}


void search_for_voltage_registers(){
  uint16_t u16;
  for (uint8_t i=0; i <= 0x7F; i+=2){


    
    read_psu_mcu_u16(i, u16);
    registers[i] = u16;
    if ((i==0x0E) ||
        //((i > 0x40) && (i<0x60)) ||

        ((i!=0x40) &&
        (i!=0x1E) && 
        (u16 >= 0xb00) && 
        (u16 <= 0xF00))){
      Telnet.print("Possible voltage register: ");
      print_byte(i);
      Telnet.print(" ");
      print_byte(u16 >> 8);
      Telnet.print(" ");
      print_byte(u16 & 0xFF);
      
      Telnet.print(" ");
      Telnet.print(u16 / 256.);

      Telnet.println("v");
    }
  }
}


void search_for_voltage_eeprom(){
  uint16_t u16;
  for (uint8_t i=0; i <= 0x7F; i+=2){


    
    read_psu_mcu_u16(i, u16);
    registers[i] = u16;
    if ((i==0x0E) ||
        //((i > 0x40) && (i<0x60)) ||

        ((i!=0x40) &&
        (i!=0x1E) && 
        (u16 >= 0xb00) && 
        (u16 <= 0xF00))){
      Telnet.print("Possible voltage register: ");
      print_byte(i);
      Telnet.print(" ");
      print_byte(u16 >> 8);
      Telnet.print(" ");
      print_byte(u16 & 0xFF);
      
      Telnet.print(" ");
      Telnet.print(u16 / 256.);

      Telnet.println("v");
    }
  }
}

/*
void fuzz(){
  uint8_t reg;
  uint8_t bit;


  uint16_t u16 = 0;
  uint16_t mask;
  for (uint8_t i=0; i<255;++i){
    read_psu_mcu_u16(i, u16);
    registers[i] = u16;
    registers_old[i] = u16;
    registers_last_change[i] = u16;
    registers_last_change_age[i]=0xFF;

    eeprom[i] = read_eeprom_byte(i);
    eeprom_old[i] = eeprom[i];
    eeprom_last_change[i] = eeprom[i];
    eeprom_last_change_age[i] = 0xFF;
  }

  for (reg = 0x2E; reg <= 0xFF; reg++){
    for (bit=0; bit<16;bit++){
      print_byte(reg);
      Telnet.print(": ");
      mask = (uint16_t)(1<<bit);
      print_bits(mask >> 8);
      Telnet.print(" ");
      print_bits(mask & 0xFF);
      Telnet.println();
      write_psu_mcu_u16(reg, (uint16_t)(1<<bit));
      read_all_psu_registers();
      yield();
      ArduinoOTA.handle();
      handleTelnet();
      read_all_eeprom_changes();

      for (uint8_t i=0; i<255;++i){
        if (ignore_registers[i]) continue;

        if (registers_last_change_age[i] == 0){
          Telnet.print("Register ");
          print_byte(i);
          Telnet.print(" changed from ");
          Telnet.print(registers_last_change[i]);
          Telnet.print(" to ");
          Telnet.print(registers[i]);
          Telnet.print(" after reg ");
          print_byte(reg);
          Telnet.print(" bit ");
          Telnet.println(bit);  
        }
      }

      for (uint8_t i=0; i<255;++i){
        //if (ignore_registers[i]) continue;

        if (eeprom_last_change_age[i] == 0){
          Telnet.print("EEPROM location ");
          print_byte(i);
          Telnet.print(" changed from ");
          Telnet.print(eeprom_last_change[i]);
          Telnet.print(" to ");
          Telnet.print(eeprom[i]);
          Telnet.print(" after reg ");
          print_byte(reg);
          Telnet.print(" bit ");
          Telnet.println(bit);  
        }
      }

      force_psu_fan(3200);
    }
  }  
}

*/

void write_psu_mcu_nothing(uint8_t reg){
  
  uint8_t cs = (psu_mcu_addr<<1) + reg;
  uint8_t reg_cs = ((0xff-cs)+1) & 0xff;
/*
  print_byte(reg); Telnet.print(" ");
  print_byte(val_lsb); Telnet.print(" ");
  print_byte(val_msb); Telnet.print(" ");
  //print_byte(cs); Telnet.println(" ");
  print_byte(reg_cs); Telnet.println(" ");
  
*/
  Wire.beginTransmission(psu_mcu_addr);
  Wire.write((uint8_t)(reg));
  Wire.write((uint8_t)(reg_cs));
  uint8_t res = Wire.endTransmission();
  Telnet.print("nothing result: ");
  Telnet.println(res);

}


void write_psu_mcu_u8(uint8_t reg, uint8_t val){
  
  uint8_t cs = (psu_mcu_addr<<1) + reg + val;
  uint8_t reg_cs = ((0xff-cs)+1) & 0xff;
/*
  print_byte(reg); Telnet.print(" ");
  print_byte(val_lsb); Telnet.print(" ");
  print_byte(val_msb); Telnet.print(" ");
  //print_byte(cs); Telnet.println(" ");
  print_byte(reg_cs); Telnet.println(" ");
  
*/
  Wire.beginTransmission(psu_mcu_addr);
  Wire.write((uint8_t)(reg));
  Wire.write((uint8_t)(val));
  Wire.write((uint8_t)(reg_cs));
  Wire.endTransmission();

}

void write_psu_mcu_u16(uint8_t reg, uint16_t val){
  
  uint8_t val_lsb = val & 0xff;
  uint8_t val_msb = val >> 8;

  uint8_t cs = (psu_mcu_addr<<1) + reg + val_lsb + val_msb;
  uint8_t reg_cs =((0xff-cs)+1) & 0xff;
/*
  print_byte(reg); Telnet.print(" ");
  print_byte(val_lsb); Telnet.print(" ");
  print_byte(val_msb); Telnet.print(" ");
  //print_byte(cs); Telnet.println(" ");
  print_byte(reg_cs); Telnet.println(" ");
  
*/
  Wire.beginTransmission(psu_mcu_addr);
  Telnet.print("[>");
  print_byte(psu_mcu_addr); Telnet.print("] ");
  Wire.write((uint8_t)(reg));
  print_byte(reg); Telnet.print(": ");
  Wire.write((uint8_t)(val_lsb));
  print_byte(val_lsb); Telnet.print(" ");
  Wire.write((uint8_t)(val_msb));
  print_byte(val_msb); Telnet.print(" ");
  Wire.write((uint8_t)(reg_cs));
  print_byte(reg_cs); Telnet.print(" ");
  Wire.endTransmission();
  Telnet.println("[S]");

}

void force_psu_fan(uint16_t rpm){
  write_psu_mcu_u16(0x40, rpm);
}

void write_psu_mcu_f16(uint8_t reg, double val, double scale){
  uint16_t v = (uint16_t)(val / scale);
  write_psu_mcu_u16(reg, v);
}
/****************************************************** S E T U P */

void setup() {

  

  Serial.begin(115200);
  Serial.println("Start");

  reconnect_wifi();
 
  ArduinoOTA.begin(); 
 
  TelnetServer.begin();
  TelnetServer.setNoDelay(true);
  Telnet.println("Ready");
  Telnet.println("IP address: ");
  Telnet.println(WiFi.localIP());
  Serial.println(WiFi.localIP());

  //Wire.setClock(100000);
  Wire.begin();  
  while (psu_mem_addr == 0xFF){
    Telnet.println("Scanning for EEPROM.");
    scan_for_device(0x50, 0x57, psu_mem_addr);
    my_yield();
  }
  read_eeprom();

  while (psu_mcu_addr == 0xFF){
    Telnet.println("Scanning for MCU.");
    scan_for_device(0x58, 0x5F, psu_mcu_addr);
    my_yield();
  }
  my_yield();
  read_psu_mcu_registers_init();
  setup_ignore_registers();
  force_psu_fan(3200);


  pinMode(LED_BUILTIN, OUTPUT);
}




/****************************************************** M A I N  L O O P */

void my_yield(){
  if (WiFi.status() != WL_CONNECTED) {  
    reconnect_wifi();
  }  
  handleTelnet();
  ArduinoOTA.handle();
  yield();
  
}

uint8_t bootdelay = 20;
void loop() {
  my_yield();
  //factory_reset_eeprom();
  //read_psu_mcu_changing_registers();
  Telnet.println(read_eeprom_byte(0x12), HEX);
  Telnet.println("EEPROM");
  read_entire_eeprom();
  Telnet.println("MCU");
  dump_all_mcu_registers();
  //scan_for_device(0x58, 0x5F, psu_mcu_addr);
  //Telnet.println('-');

  /*Telnet.print("MCU addr: ");
  print_byte(psu_mcu_addr);
  Telnet.println();
*/

  //read_entire_eeprom();
/*  uint16_t u16;
  u16 = (((read_eeprom_byte(0x32)) << 8) + (read_eeprom_byte(0x33) && 0xFF));
  print_byte(u16 >> 8);
  Telnet.print(" ");
  print_byte(u16 && 0xFF);
  Telnet.println();
*//*

  uint8_t u8;
  read_psu_mcu_u8(0x02, u8);
  print_byte(u8);
  Telnet.print(" ");
  
  Telnet.println(u8);
*/

  /*uint16_t u16;
  read_psu_mcu_u16(0x1E, u16);
  print_byte(u16 >> 8);
  Telnet.print(" ");
  print_byte(u16 && 0xFF);
  Telnet.println();
*/
  /*fuzz();
  Telnet.println(".");
  write_psu_mcu_f16(0x44, 13.8, 1/256);
  write_psu_mcu_f16(0x46, 13.8, 1/256);
  write_psu_mcu_f16(0x48, 13.8, 1/256);
  write_psu_mcu_f16(0x4A, 13.8, 1/256);
  write_psu_mcu_f16(0x4C, 13.8, 1/256);
  write_psu_mcu_f16(0x4E, 13.8, 1/256);
  write_psu_mcu_f16(0x50, 13.8, 1/256);
  write_psu_mcu_f16(0x52, 13.8, 1/256);
  write_psu_mcu_f16(0x54, 13.8, 1/256);
  write_psu_mcu_f16(0x56, 13.8, 1/256);
*/


  //write_psu_mcu_f16(0x44, 13.8, 1/256);
  
  //fuzz(); 
  /*
  read_psu_mcu_changing_registers();

  if (test_cmd != 0){
    if (bootdelay > 0) {
      Telnet.print("\nExecuting in: ");
      Telnet.println(bootdelay);
      bootdelay--;
    } else if (bootdelay == 0){
      Telnet.println("\nExecuted");
      if ((test_cmd != 0x40) && (test_cmd != 0x3c)){
        write_psu_mcu_u8(0x00, 0x03);
      }
      //test_cmd++;
      bootdelay = 20;    
    }
  } else {
    read_psu_mcu_changing_registers();
  }
*/

  
  /*
  double psu_out_volt;
  double psu_out_amp;
  double psu_out_max_amp;
  //Telnet.println();
  delay(100);
  //Telnet.println("\033c");
  if (read_psu_out_voltage(psu_out_volt) && 
      read_psu_out_amperage(psu_out_amp) &&
      read_psu_out_max_amperage(psu_out_max_amp)
    ){

    Telnet.print(psu_out_volt);
    Telnet.print("V ");
    Telnet.print(psu_out_amp);
    Telnet.print("A ");
    Telnet.print(psu_out_max_amp);
    Telnet.println("A (max)");
    delay(400);
  } else {
    Telnet.println("Error reading out voltage and current");
  }

*/
/*
  if ((psu_out_max_amp > 30) && (psu_out_amperage < 10)){
    Telnet.println("Resetting max amps");
    
    uint16_t u16;
    read_psu_mcu_u16(0x36, u16);
    write_psu_mcu_u16(0x37, 0x00);
    //write_psu_mcu_u8(0x58, 0x37);

    //write_psu_mcu_u16(0x37, 0x00);
    // write_psu_mcu_u16(0x36, 0); //works by overwriting mem
     read_psu_mcu_u16(0x36, u16);
  }
*/
  //fuzz_for_voltage();
  //search_for_voltage_registers();
  //write_psu_mcu_f16(0x52, 12.5, 1./256.);
  //delay(100);

/*
  double psu_intake_temp;
  double psu_internal_temp;
  if (read_psu_intake_temp(psu_intake_temp) && read_psu_internal_temp(psu_internal_temp)){

    Telnet.print(psu_intake_temp);
    Telnet.print("C ");
    Telnet.print(psu_internal_temp);
    Telnet.println("C");
  } else {
    Telnet.println("Error reading temperatures");
  }

  */
  
  /*Telnet.print("MCU ");
  print_byte(psu_mcu_addr);
  Telnet.println();
*/

/*
  double actual_fan_speed;
  double desired_fan_speed;
  if (read_psu_fan_speed_actual(actual_fan_speed) && read_psu_fan_speed_desired(desired_fan_speed)){
    Telnet.print("Fan speed: ");
    Telnet.print(fan_speed);
    Telnet.print(" (commanded)  ");
    Telnet.print(actual_fan_speed);
    Telnet.print(" (actual) ");
    Telnet.print(desired_fan_speed);
    Telnet.println(" (desired)");
  } else {
    Telnet.println("Error reading fan speed");
  }
  
*/
/*
  if (psu_mcu_addr != 0xFF){
    force_psu_fan(fan_speed);
    if (fan_speed > 1000){
      fan_speed -= 10;
    } else { 
      fan_speed = 5000;
    }
    delay(500);
    double actual_fan_speed;
    double desired_fan_speed;
    if (read_psu_fan_speed_actual(actual_fan_speed) && read_psu_fan_speed_desired(desired_fan_speed)){
      Telnet.print("Fan speed: ");
      Telnet.print(fan_speed);
      Telnet.print(" (commanded)  ");
      Telnet.print(actual_fan_speed);
      Telnet.print(" (actual) ");
      Telnet.print(desired_fan_speed);
      Telnet.println(" (desired)");
    } else {
      Telnet.println("Error reading fan speed");
    }
    double involt=0;

    if (read_psu_grid_voltage(involt)){
      Telnet.print("In voltage ");
      Telnet.print(involt);
      Telnet.println("V");
    } else {
      Telnet.println("Error reading voltage");
    }

    delay(500);
  }
*/
}
  
