slundell/dps_charger/(commit log)

2019-08-15 Added images and some i2c signal grabs
2019-08-16 Added voltage range images
2019-08-17 A lot of fuzzing and testing. Renamed dps_charger.ino to dps_re.ino. Will be using this for RE attempts while doing the charger code under the original name.
2019-08-20 First iteration of the actual charger program. Basic regulation CC/CV works, but has many problems.
2019-08-20 Added CPU board image
2019-08-21 Updating board annotations
2019-08-24 Added new high resolution PCB images
2019-08-27 pin 35 & 36 notes
2019-09-01 Major rearrangement of repo
    [cpu_board.kicad_pcb, cpu_board.sch]
